Kagiso-me/3D-Prints/rackstack/media/features/slideOpt.gif

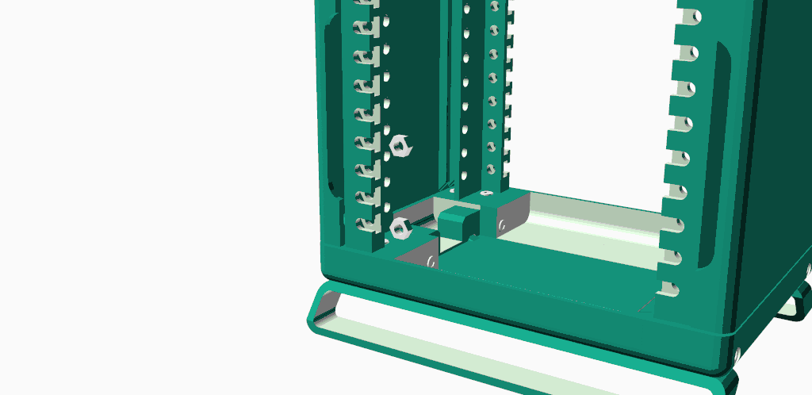
rackstack/media/features/slideOpt.gif
