Kagiso-me/3D-Prints/rackstack/media/features/stackConnectorOpt.gif

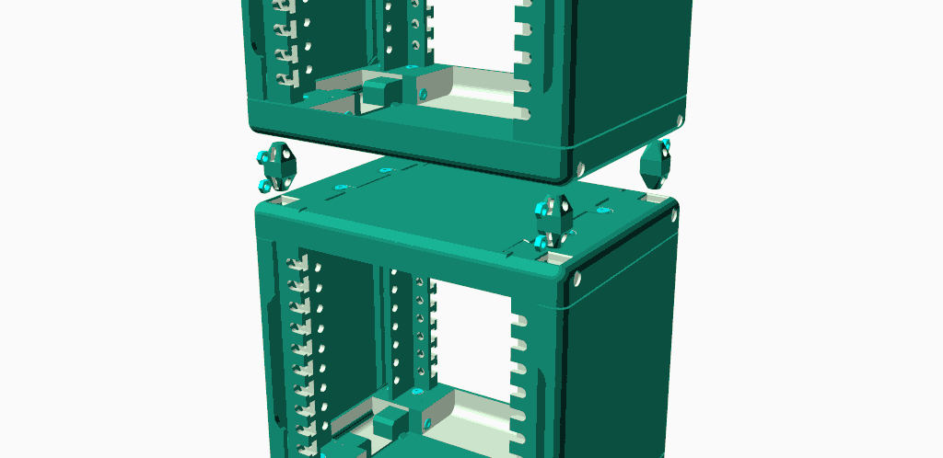
rackstack/media/features/stackConnectorOpt.gif
