Kagiso-me/3D-Prints/rackstack/media/features/swivelOpt.gif

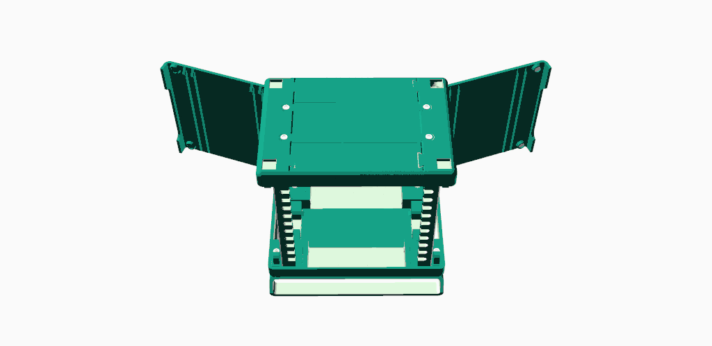
rackstack/media/features/swivelOpt.gif
