Kagiso-me/3D-Prints/rackstack/rack-mount/angle-bracket/animate.gif

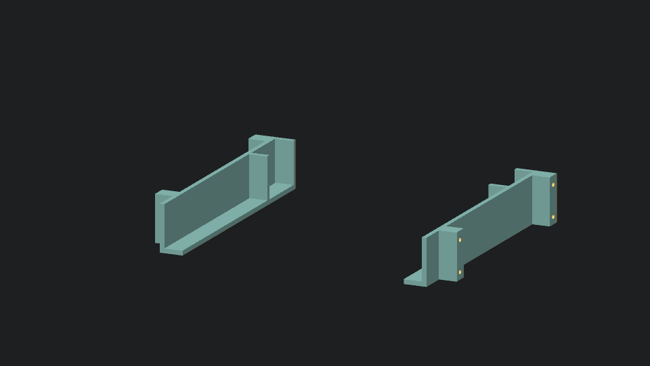
rackstack/rack-mount/angle-bracket/animate.gif
