Kagiso-me/3D-Prints/rackstack/rack-mount/enclosed-box/animate.gif

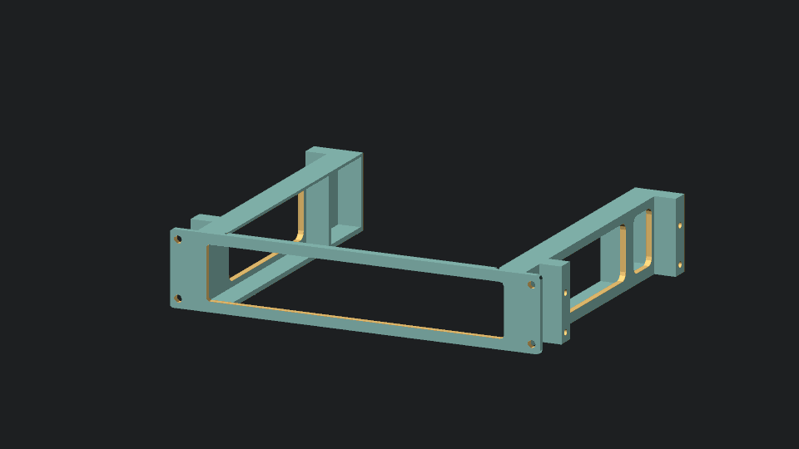
rackstack/rack-mount/enclosed-box/animate.gif
