Kagiso-me/3D-Prints/rackstack/rack-mount/patch-panel/animate.gif

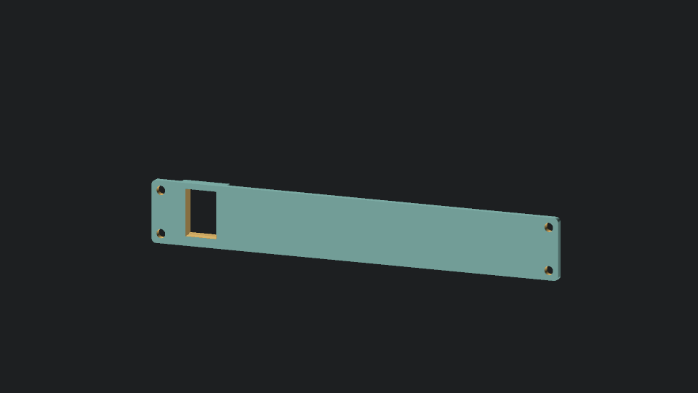
rackstack/rack-mount/patch-panel/animate.gif
