Kagiso-me/3D-Prints/rackstack/rack-mount/tray/animate.gif

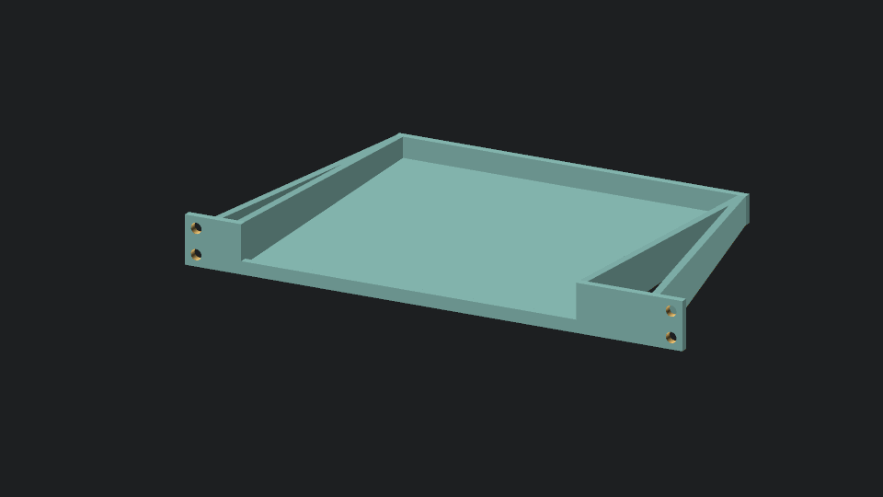
rackstack/rack-mount/tray/animate.gif
