Kagiso-me/3D-Prints/rackstack/media/bom/fhcs_short.gif

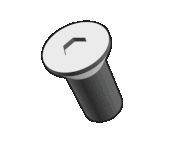
rackstack/media/bom/fhcs_short.gif
