Kagiso-me/3D-Prints/rackstack/stl/mini/rack/mainRail_P.stl

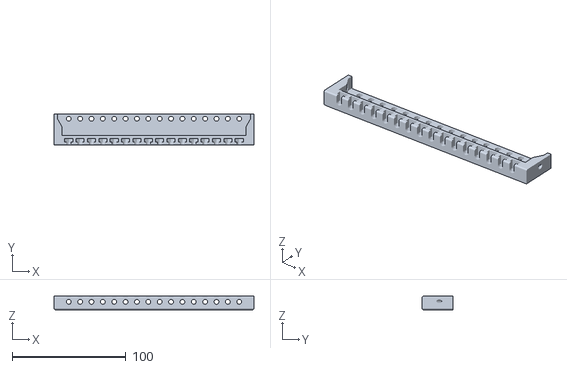
[picture p16: CAD file, 2024-10-22]
rackstack/stl/mini/rack/mainRail_P.stl
176.0 x 27.0 x 12.0
