Kagiso-me/3D-Prints/rackstack/stl/micro/rack/mainRail_P.stl

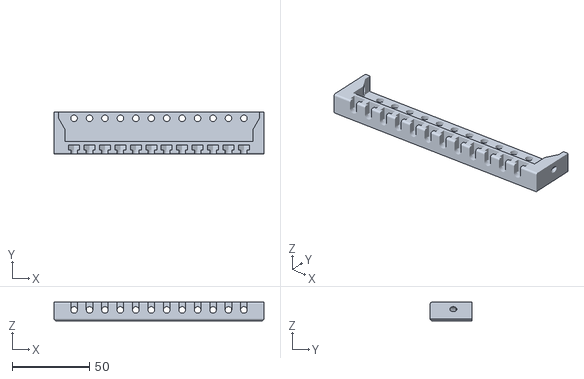
[picture p17: CAD file, 2024-10-22]
rackstack/stl/micro/rack/mainRail_P.stl
136.0 x 27.0 x 12.0
