Kagiso-me/3D-Prints/rackstack/stl/nano/rack/mainRail_P.stl

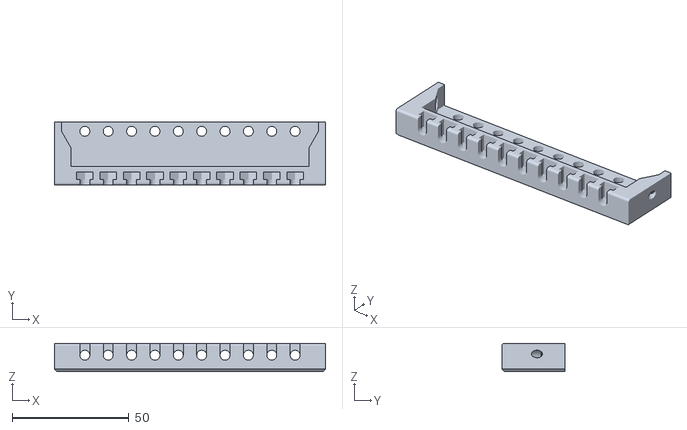
[picture p18: CAD file, 2024-10-22]
rackstack/stl/nano/rack/mainRail_P.stl
116.0 x 27.0 x 12.0
