Kagiso-me/3D-Prints/rackstack/stl/micro/rack/magnetModuleLeft_P.stl

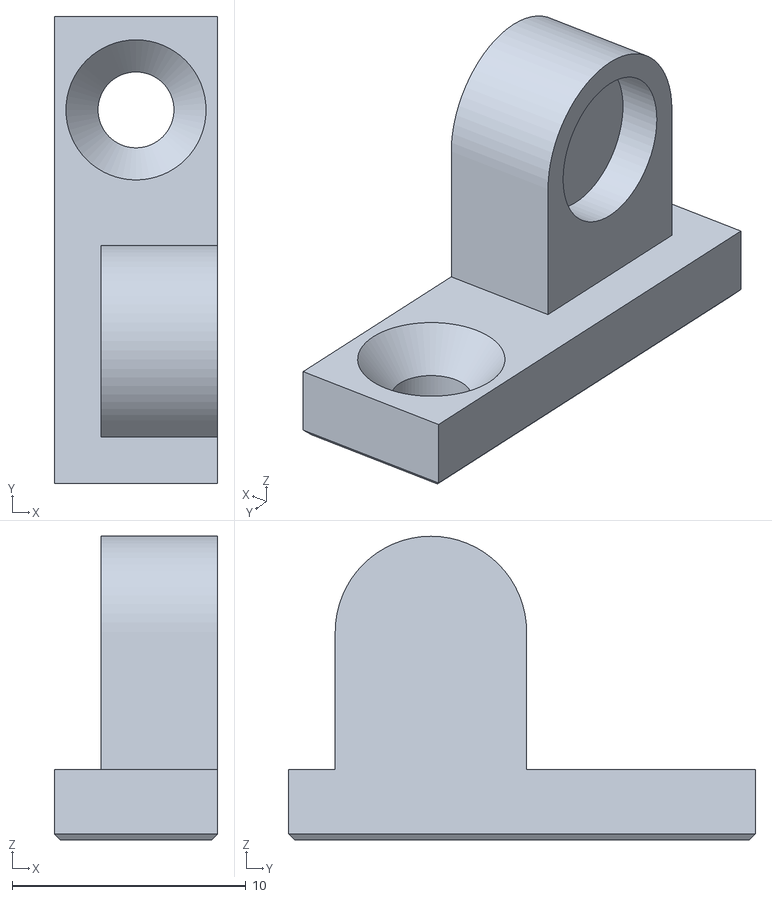
[picture p19: CAD file, 2024-10-22]
rackstack/stl/micro/rack/magnetModuleLeft_P.stl
7.00 x 20.0 x 13.0
