Kagiso-me/3D-Prints/rackstack/stl/mini/rack/sideWallLeft_P.stl

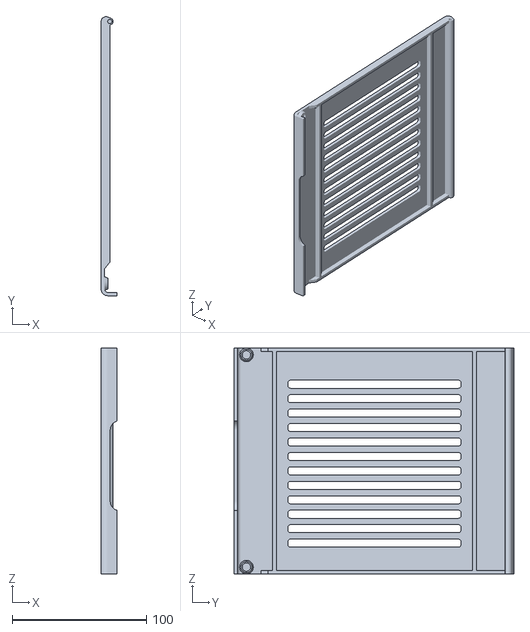
[picture p20: CAD file, 2024-10-22]
rackstack/stl/mini/rack/sideWallLeft_P.stl
11.8 x 208.3 x 168.4
