Kagiso-me/3D-Prints/rackstack/stl/micro/rack/xyPlate_P.stl

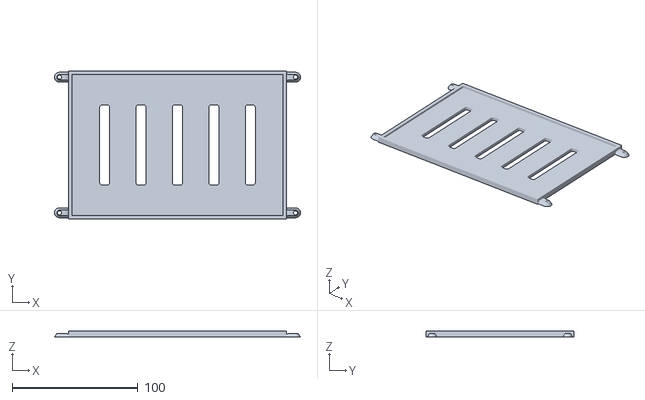
[picture p21: CAD file, 2024-10-22]
rackstack/stl/micro/rack/xyPlate_P.stl
196.0 x 118.0 x 5.00
