Kagiso-me/3D-Prints/rackstack/stl/mini/rack/stackConnectorBottom_P.stl

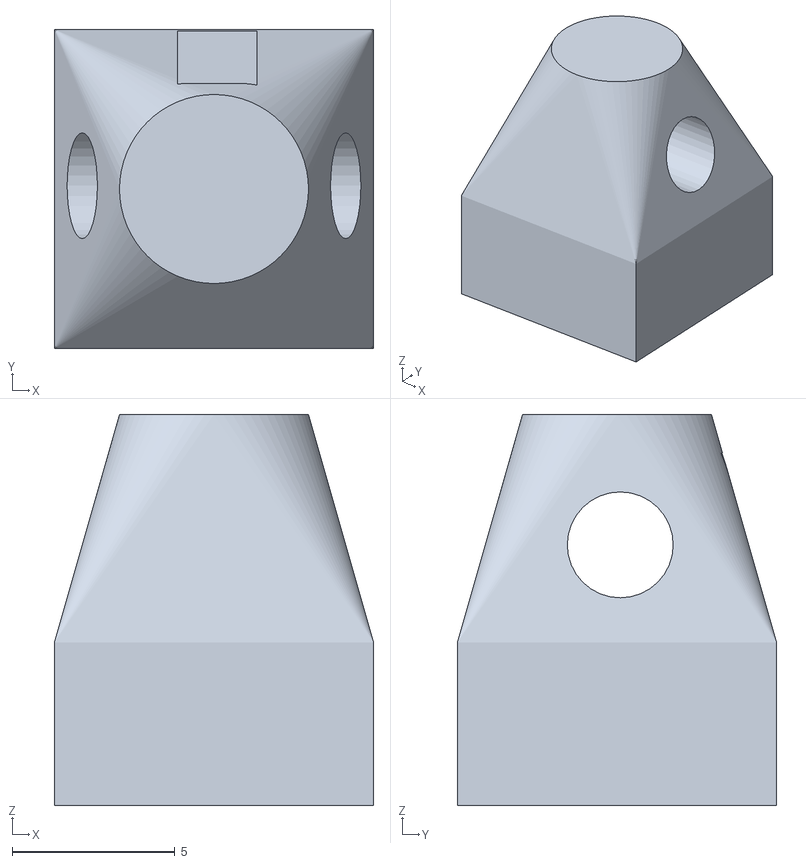
[picture p22: CAD file, 2024-10-22]
rackstack/stl/mini/rack/stackConnectorBottom_P.stl
9.80 x 9.80 x 12.0
