Kagiso-me/3D-Prints/rackstack/stl/micro/rack/sideWallLeft_P.stl

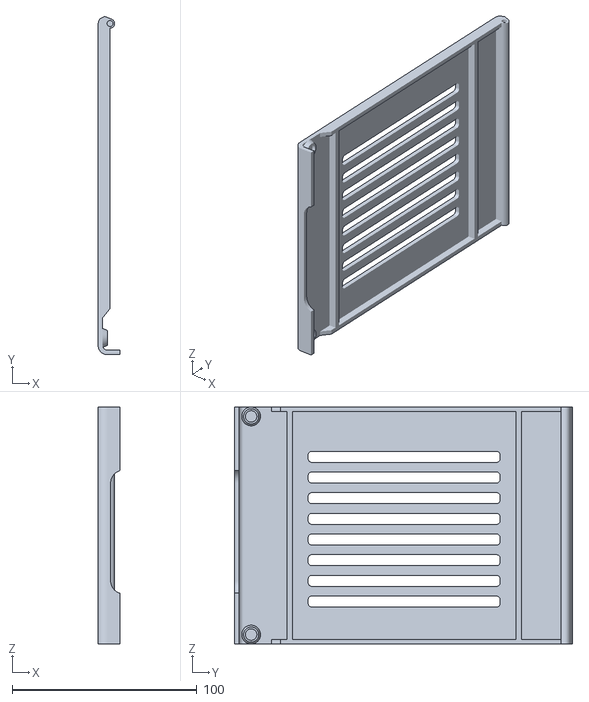
[picture p23: CAD file, 2024-10-22]
rackstack/stl/micro/rack/sideWallLeft_P.stl
11.8 x 183.3 x 128.4
