Kagiso-me/3D-Prints/rackstack/stl/mini/rack/yBarRight_P.stl

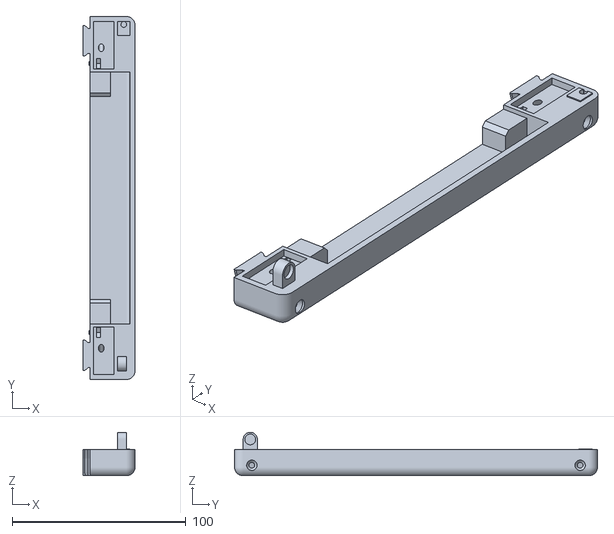
[picture p24: CAD file, 2024-10-22]
rackstack/stl/mini/rack/yBarRight_P.stl
30.0 x 209.0 x 25.0
