Kagiso-me/3D-Prints/rackstack/stl/nano/rack/sideWallRight_P.stl

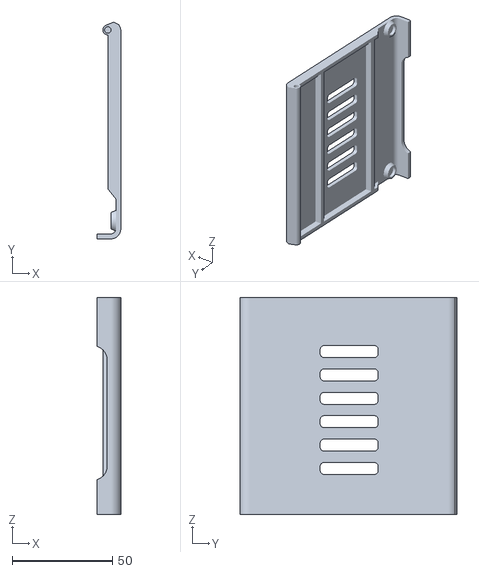
[picture p25: CAD file, 2024-10-22]
rackstack/stl/nano/rack/sideWallRight_P.stl
11.8 x 108.3 x 108.4
