Kagiso-me/3D-Prints/rackstack/stl/nano/rack/rackFeet_P.stl

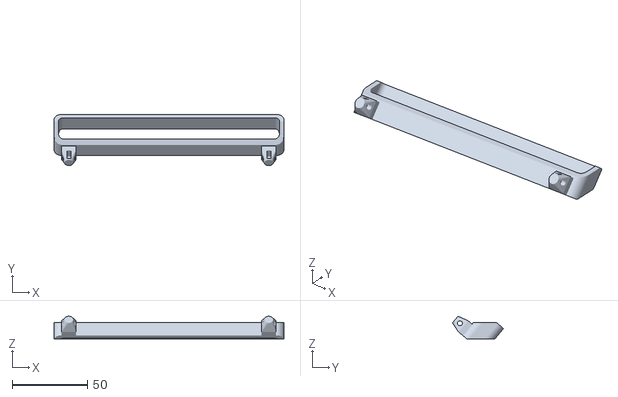
[picture p26: CAD file, 2024-10-22]
rackstack/stl/nano/rack/rackFeet_P.stl
153.0 x 34.0 x 15.0
