Kagiso-me/3D-Prints/rackstack/stl/micro/rack/eval_P.stl

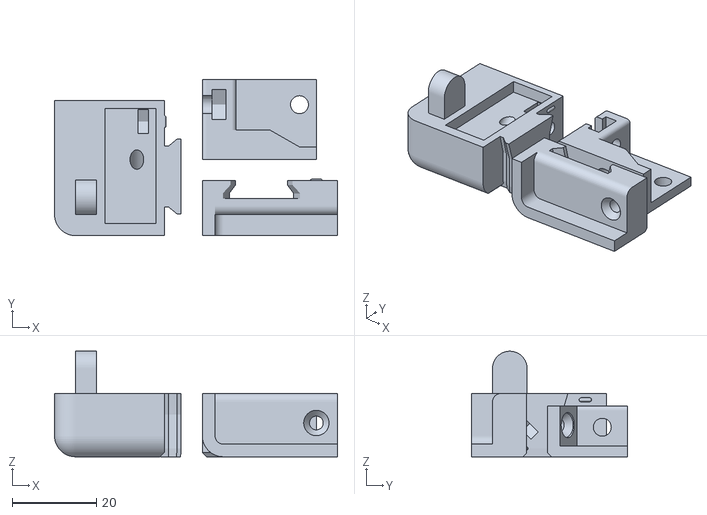
[picture p27: CAD file, 2024-10-22]
rackstack/stl/micro/rack/eval_P.stl
67.0 x 37.0 x 25.0
