Kagiso-me/3D-Prints/rackstack/stl/mini/rack/xBar_P.stl

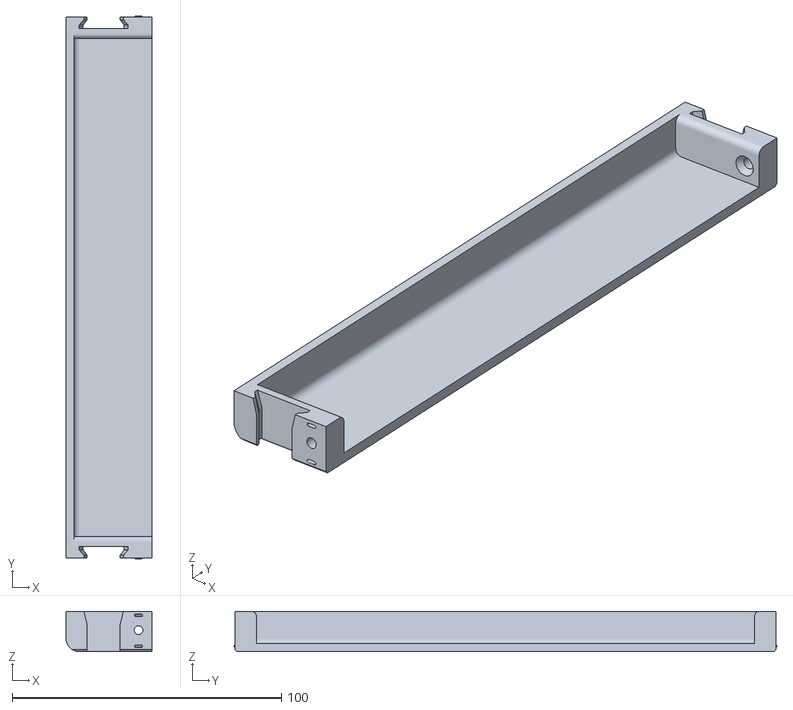
[picture p28: CAD file, 2024-10-22]
rackstack/stl/mini/rack/xBar_P.stl
32.0 x 201.8 x 15.0
