Kagiso-me/3D-Prints/rackstack/stl/micro/rack/rackFeet_P.stl

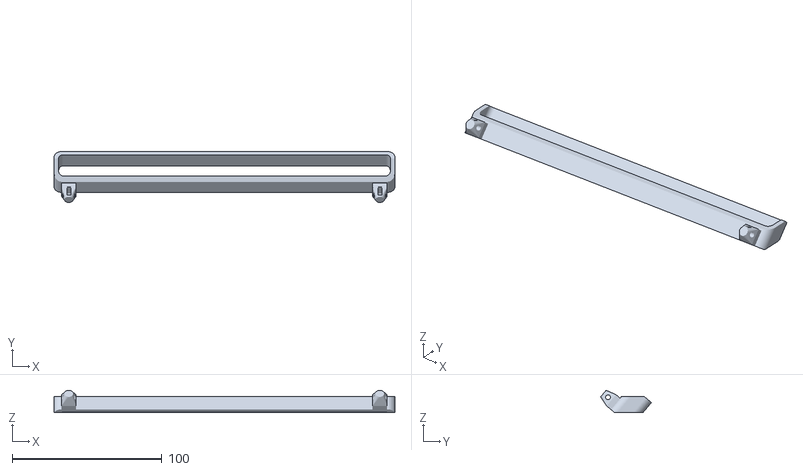
[picture p29: CAD file, 2024-10-22]
rackstack/stl/micro/rack/rackFeet_P.stl
228.0 x 34.0 x 15.0
