Kagiso-me/3D-Prints/rackstack/stl/mini/rack/xyPlate_P.stl

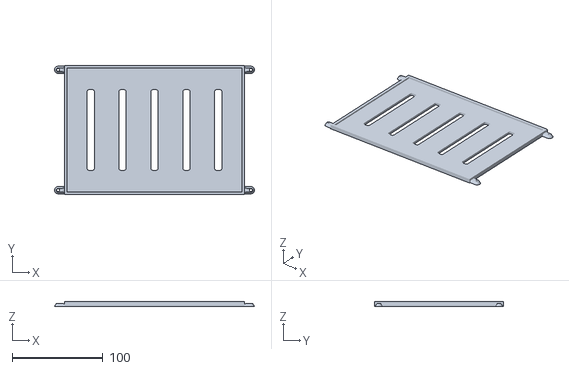
[picture p30: CAD file, 2024-10-22]
rackstack/stl/mini/rack/xyPlate_P.stl
221.0 x 143.0 x 5.00
