Kagiso-me/3D-Prints/rackstack/stl/micro/rack/hingeModule.stl

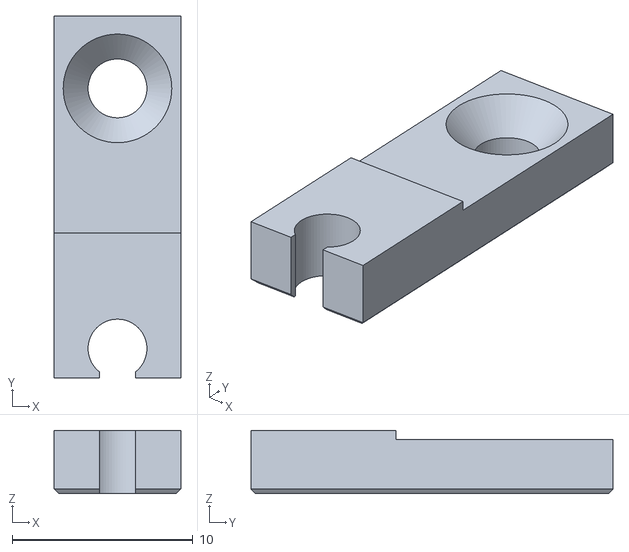
[picture p31: CAD file, 2024-10-22]
rackstack/stl/micro/rack/hingeModule.stl
7.00 x 20.0 x 3.50
