Kagiso-me/3D-Prints/rackstack/stl/nano/rack/yBar_P.stl

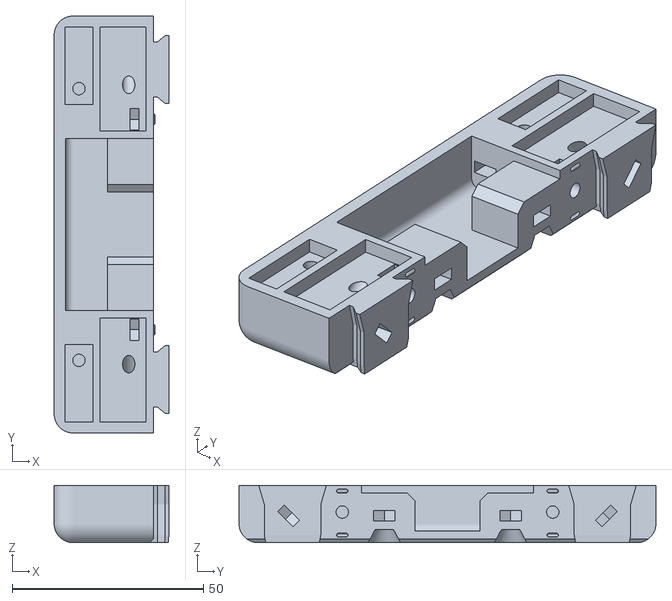
[picture p32: CAD file, 2024-10-22]
rackstack/stl/nano/rack/yBar_P.stl
30.0 x 109.0 x 15.0
