Kagiso-me/3D-Prints/rackstack/stl/micro/rack/rackJoiner_P.stl

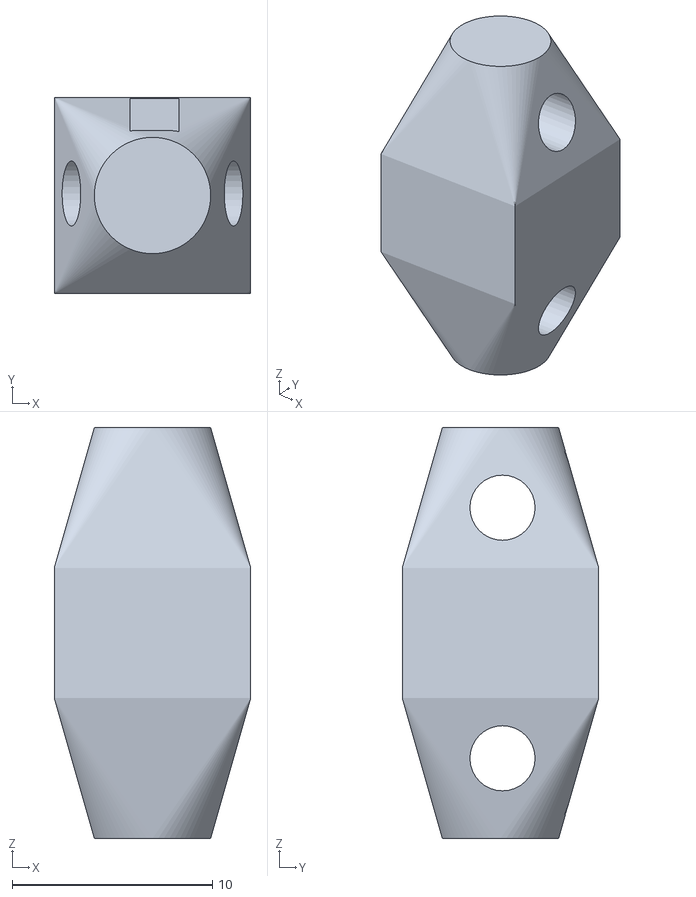
[picture p33: CAD file, 2024-10-22]
rackstack/stl/micro/rack/rackJoiner_P.stl
9.80 x 9.80 x 20.5
