Kagiso-me/3D-Prints/rackstack/stl/nano/rack/yBarRight_P.stl

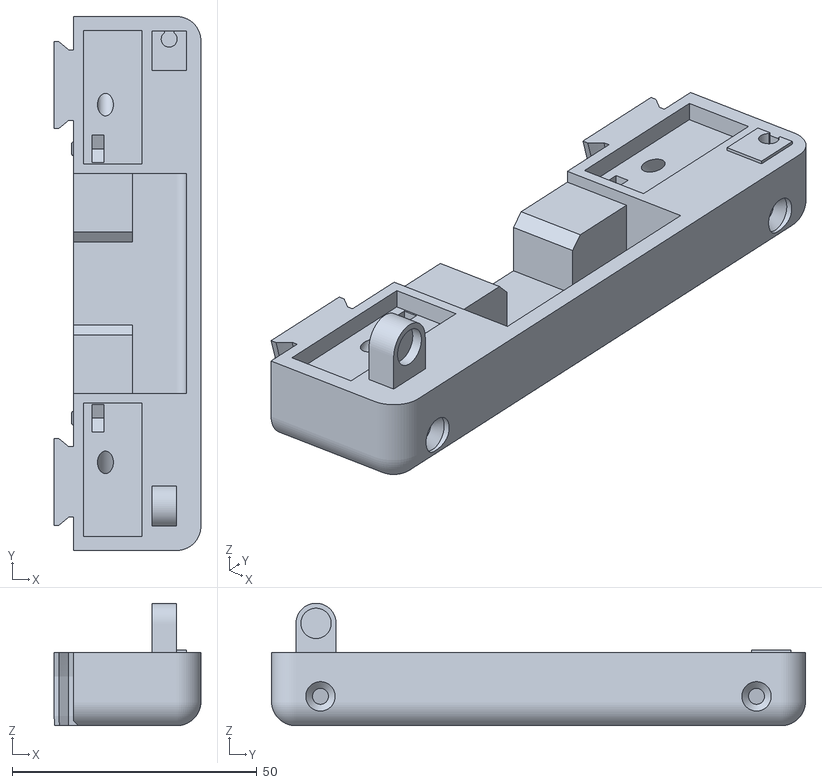
[picture p34: CAD file, 2024-10-22]
rackstack/stl/nano/rack/yBarRight_P.stl
30.0 x 109.0 x 25.0
