Kagiso-me/3D-Prints/rackstack/stl/mini/rack/rackFeet_P.stl

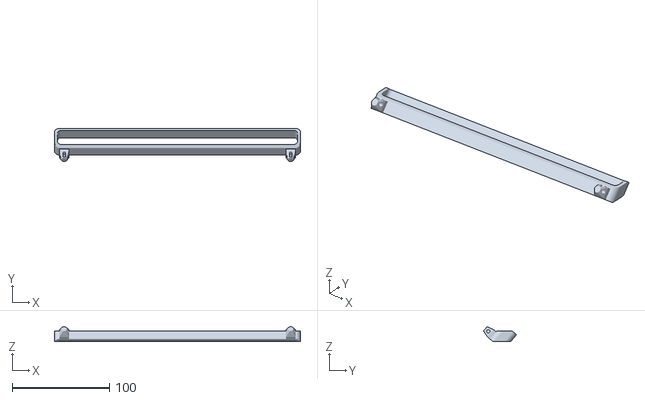
[picture p35: CAD file, 2024-10-22]
rackstack/stl/mini/rack/rackFeet_P.stl
253.0 x 34.0 x 15.0
