Kagiso-me/3D-Prints/rackstack/stl/nano/rack/xBar_P.stl

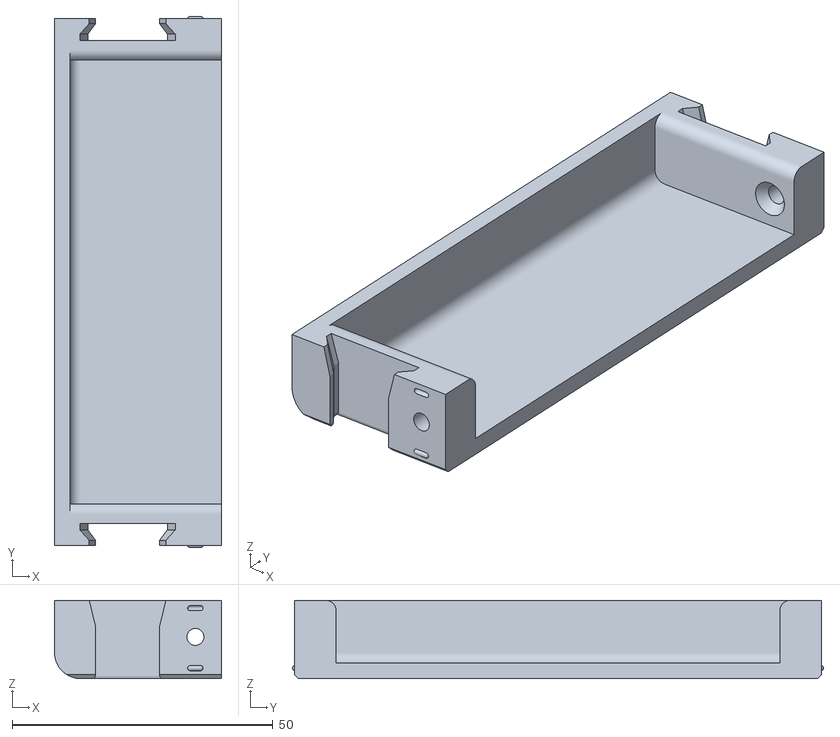
[picture p37: CAD file, 2024-10-22]
rackstack/stl/nano/rack/xBar_P.stl
32.0 x 101.8 x 15.0
