Kagiso-me/3D-Prints/rackstack/stl/mini/rack/yBar_P.stl

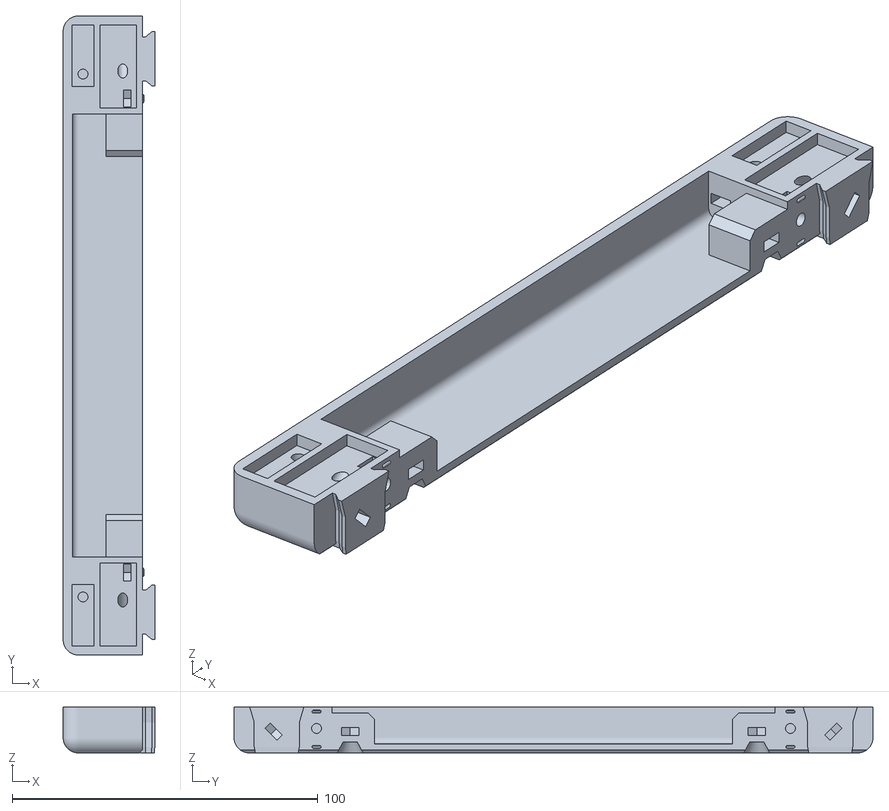
[picture p38: CAD file, 2024-10-22]
rackstack/stl/mini/rack/yBar_P.stl
30.0 x 209.0 x 15.0
