Kagiso-me/3D-Prints/rackstack/stl/nano/rack/xyPlate_P.stl

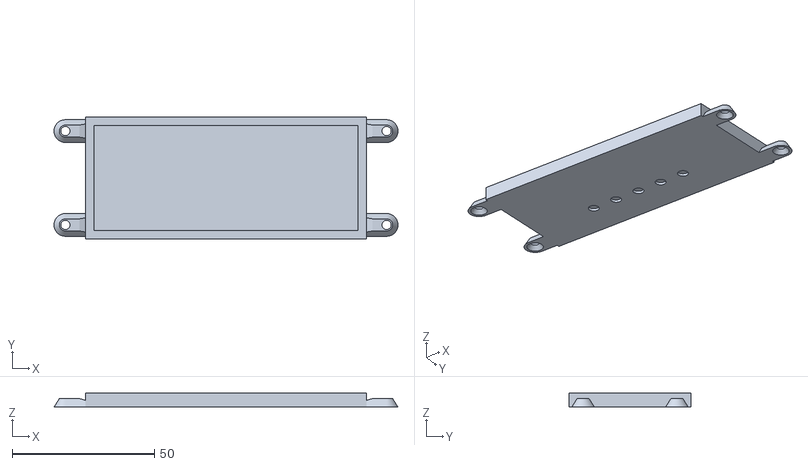
[picture p39: CAD file, 2024-10-22]
rackstack/stl/nano/rack/xyPlate_P.stl
121.0 x 43.0 x 5.00
