Kagiso-me/3D-Prints/rackstack/stl/micro/rack/xBar_P.stl

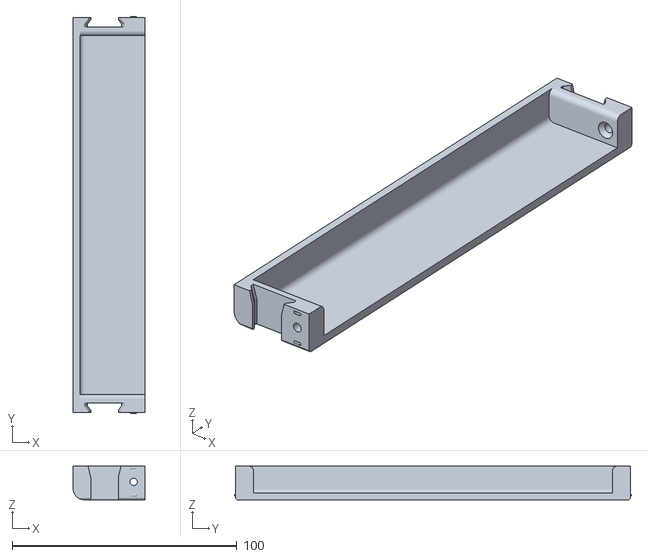
[picture p40: CAD file, 2024-10-22]
rackstack/stl/micro/rack/xBar_P.stl
32.0 x 176.8 x 15.0
