Kagiso-me/3D-Prints/rackstack/stl/micro/rack/yBar_P.stl

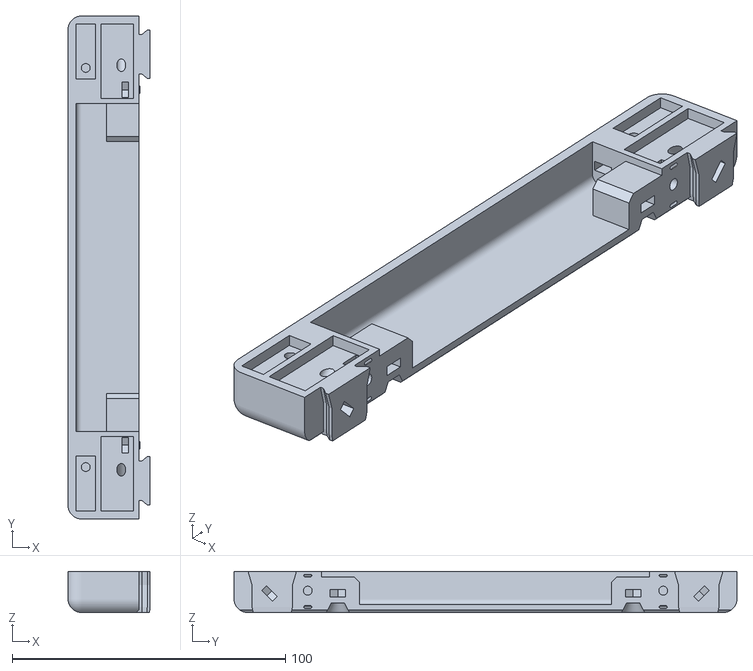
[picture p41: CAD file, 2024-10-22]
rackstack/stl/micro/rack/yBar_P.stl
30.0 x 184.0 x 15.0
