Kagiso-me/3D-Prints/(list of files, cad)

Other CAD files:
rackstack/stl/nano/rack/magnetModuleRight_P.stl
rackstack/stl/micro/rack/sideWallRight_P.stl
rackstack/stl/mini/rack/yBarLeft_P.stl
rackstack/stl/nano/rack/eval_P.stl
rackstack/stl/micro/rack/magnetModuleRight_P.stl
rackstack/stl/nano/rack/sideWallLeft_P.stl
rackstack/stl/nano/rack/magnetModuleLeft_P.stl
rackstack/stl/mini/rack/hingeModule.stl
rackstack/stl/mini/rack/eval_P.stl
rackstack/stl/nano/rack/yBarLeft_P.stl
rackstack/stl/mini/rack/sideWallRight_P.stl
rackstack/stl/micro/rack/yBarRight_P.stl
rackstack/stl/mini/rack/magnetModuleRight_P.stl
rackstack/stl/micro/rack/stackConnectorBottom_P.stl
rackstack/stl/mini/rack/magnetModuleLeft_P.stl
rackstack/stl/nano/rack/hingeModule.stl
rackstack/stl/mini/rack/rackJoiner_P.stl
rackstack/stl/nano/rack/rackJoiner_P.stl
rackstack/config/common.scad
rackstack/config/dowel.scad
rackstack/config/magnet.scad
rackstack/config/print.scad
rackstack/helper/apply.scad
rackstack/helper/common.scad
rackstack/helper/dovetail.scad
rackstack/helper/filet.scad
rackstack/helper/keystone.scad
rackstack/helper/math.scad
rackstack/helper/matrix.scad
rackstack/helper/screws.scad
rackstack/helper/sine.scad
rackstack/misc/bomAnimations.scad
rackstack/rack-mount/angle-bracket/animate.scad
rackstack/rack-mount/angle-bracket/entry.scad
rackstack/rack-mount/catalog/beelink-mini-s-tray.scad
rackstack/rack-mount/catalog/mele-quieter-tray.scad
rackstack/rack-mount/catalog/parts/sfxPSU.scad
rackstack/rack-mount/catalog/rpi-sbc-simple-box/case.scad
rackstack/rack-mount/catalog/rpi-sbc-simple-box/frontPlate.scad
rackstack/rack-mount/catalog/rpi-sbc-simple-box/top.scad
rackstack/rack-mount/common.scad
rackstack/rack-mount/dimensionHelper.scad
rackstack/rack-mount/enclosed-box/animate.scad
rackstack/rack-mount/enclosed-box/entry.scad
rackstack/rack-mount/enclosed-box/frontBoxHolder.scad
rackstack/rack-mount/enclosed-box/helper.scad
rackstack/rack-mount/enclosed-box/sideRail.scad
rackstack/rack-mount/patch-panel/animate.scad
rackstack/rack-mount/patch-panel/entry.scad
rackstack/rack-mount/patch-panel/patchPanel.scad
rackstack/rack-mount/plateBase.scad
rackstack/rack-mount/rackEars.scad
rackstack/rack-mount/tray/animate.scad
rackstack/rack-mount/tray/entry.scad
rackstack/rack-mount/tray/tray.scad
rackstack/rack/assembly/addMagnetsToMagnetModules.scad
rackstack/rack/assembly/addMagnetsToSideWall.scad
rackstack/rack/assembly/attachSideConnectorModulesToYBars.scad
rackstack/rack/assembly/attachXBarWithYBar.scad
rackstack/rack/assembly/attachXYPlates.scad
rackstack/rack/assembly/attachXYTrays.scad
rackstack/rack/assembly/common.scad
rackstack/rack/assembly/connectXYTrayWithMainRails.scad
rackstack/rack/assembly/finalBuilds.scad
rackstack/rack/assembly/insertDowelsIntoSideWall.scad
rackstack/rack/assembly/insertFeet.scad
rackstack/rack/assembly/propUpBottomXYTraywithSideWalls.scad
rackstack/rack/assembly/screwFeet.scad
rackstack/rack/assembly/screwXBarAndYBar.scad
rackstack/rack/assembly/slideHexNutToFeet.scad
rackstack/rack/assembly/slideHexNutsIntoYBar.scad
rackstack/rack/assembly/slideHexNutsIntoYBarXYPlate.scad
rackstack/rack/connector/basePlateYBarConnectors.scad
rackstack/rack/connector/connectors.scad
rackstack/rack/connector/mainRailYBarConnectors.scad
rackstack/rack/connector/sideModuleYBarConnectors.scad
rackstack/rack/connector/stackYBarConnectors.scad
rackstack/rack/connector/transformations.scad
rackstack/rack/connector/xBarYBarConnectors.scad
rackstack/rack/mainRail.scad
rackstack/rack/print/eval_P.scad
rackstack/rack/print/hingeModule.scad
rackstack/rack/print/magnetModuleLeft_P.scad
rackstack/rack/print/magnetModuleRight_P.scad
rackstack/rack/print/mainRail_P.scad
rackstack/rack/print/rackFeet_P.scad
rackstack/rack/print/rackJoiner_P.scad
rackstack/rack/print/sideWallLeft_P.scad
rackstack/rack/print/sideWallRight_P.scad
rackstack/rack/print/stackConnectorBottom_P.scad
rackstack/rack/print/xBar_P.scad
rackstack/rack/print/xyPlate_P.scad
rackstack/rack/print/yBarLeft_P.scad
rackstack/rack/print/yBarRight_P.scad
rackstack/rack/sharedVariables.scad
rackstack/rack/side/hingeModule.scad
rackstack/rack/side/magnetModule.scad
rackstack/rack/side/sideWallBase.scad
rackstack/rack/side/sideWallLeft.scad
rackstack/rack/side/sideWallMagnetMount.scad
rackstack/rack/side/sideWallRight.scad
rackstack/rack/side/sideWallVariables.scad
rackstack/rack/stackEnds.scad
rackstack/rack/xBar.scad
rackstack/rack/xyPlate.scad
rackstack/rack/yBar.scad
