Kagiso-me/3D-Prints/rackstack/assembly-guide/gifs/attachSideConnectorModulesToYBars.gif

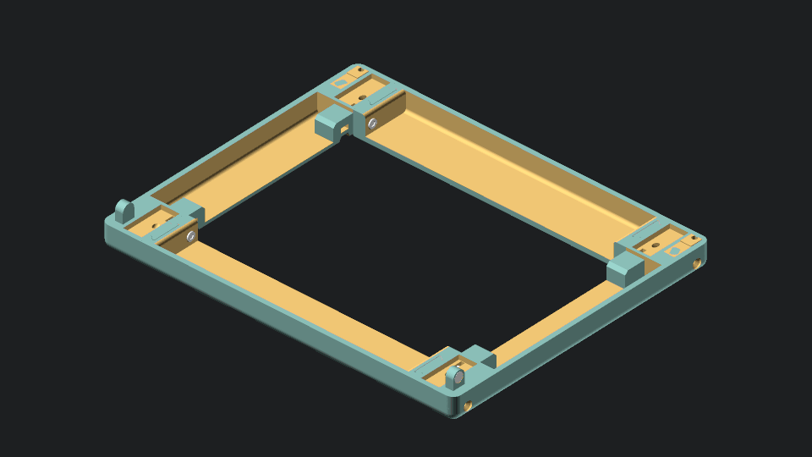
rackstack/assembly-guide/gifs/attachSideConnectorModulesToYBars.gif
