Kagiso-me/3D-Prints/(commit log)

2024-10-22 added custom profile in openscad config
    [eval_P.stl, hingeModule.stl, magnetModuleLeft_P.stl, magnetModuleRight_P.stl, mainRail_P.stl, rackFeet_P.stl, rackFrame.scad, rackJoiner_P.stl]
2024-10-22 added custom profile
    [rackFrame.scad]
2024-10-24 edited rackstack config
    [rackFrame.scad]
